houseofdouglas/halloween/stl/eye_back.stl

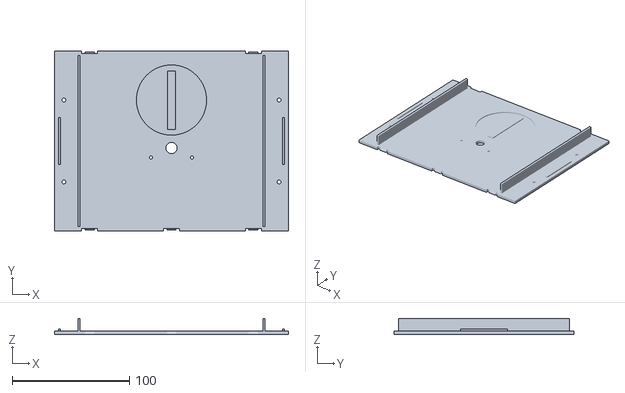
[picture p3: CAD file, 2026-10-10]
stl/eye_back.stl
200.0 x 154.0 x 13.7
