houseofdouglas/halloween/stl/eye_front.stl

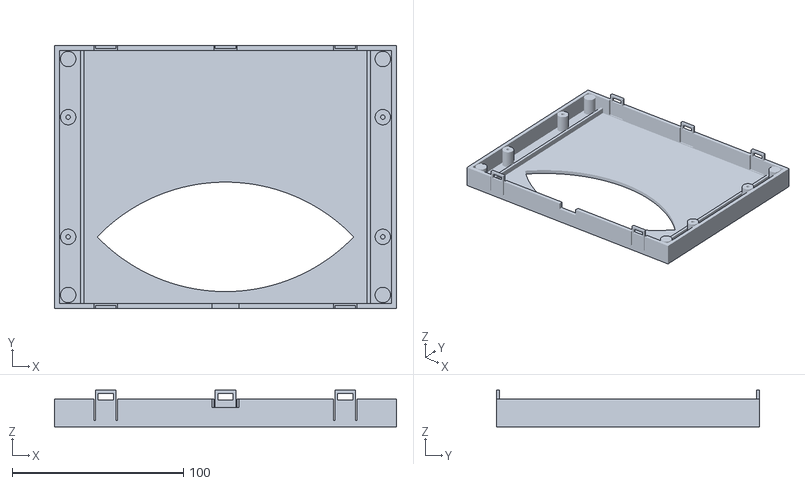
[picture p4: CAD file, 2026-10-10]
stl/eye_front.stl
200.0 x 154.0 x 21.4
