houseofdouglas/halloween/stl/snap_test.stl

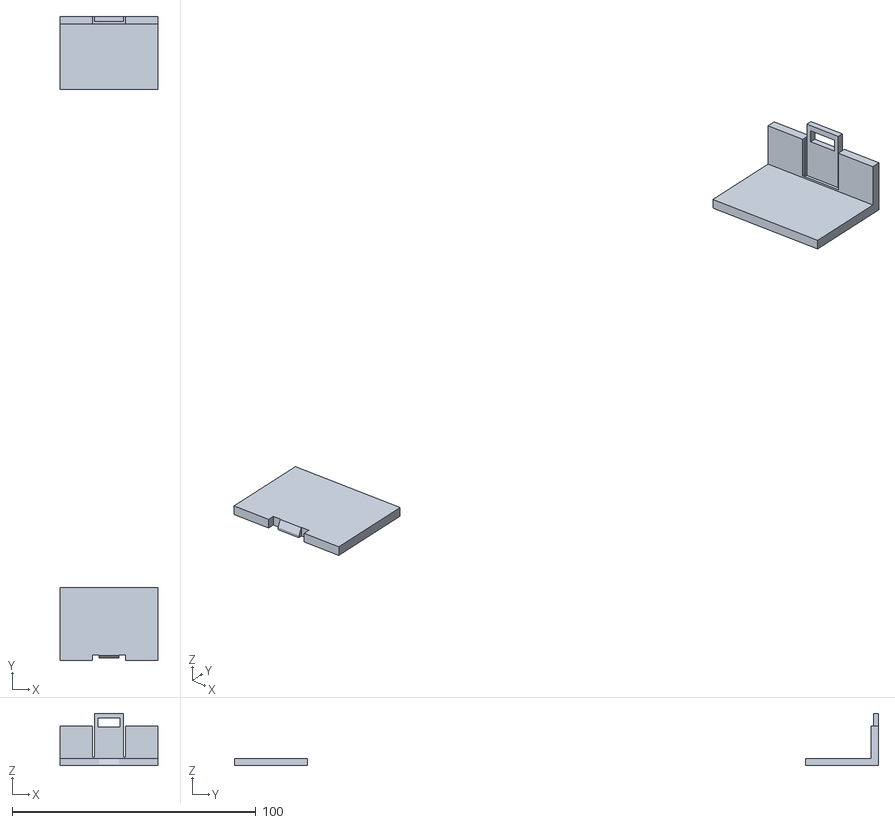
[picture p5: CAD file, 2026-10-10]
stl/snap_test.stl
40.0 x 264.0 x 21.4
