houseofdouglas/halloween/stl/eye_lid.stl

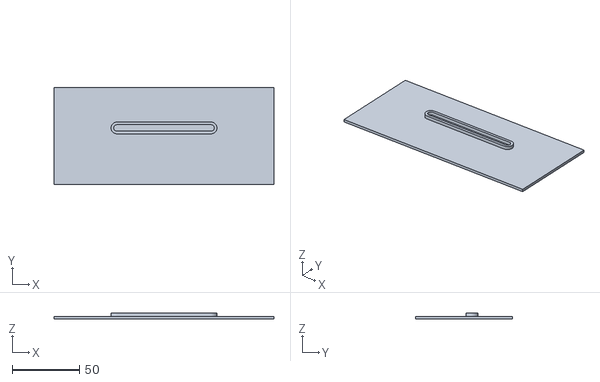
[picture p6: CAD file, 2026-10-10]
stl/eye_lid.stl
164.0 x 72.0 x 4.50
