houseofdouglas/halloween/stl/splice.stl

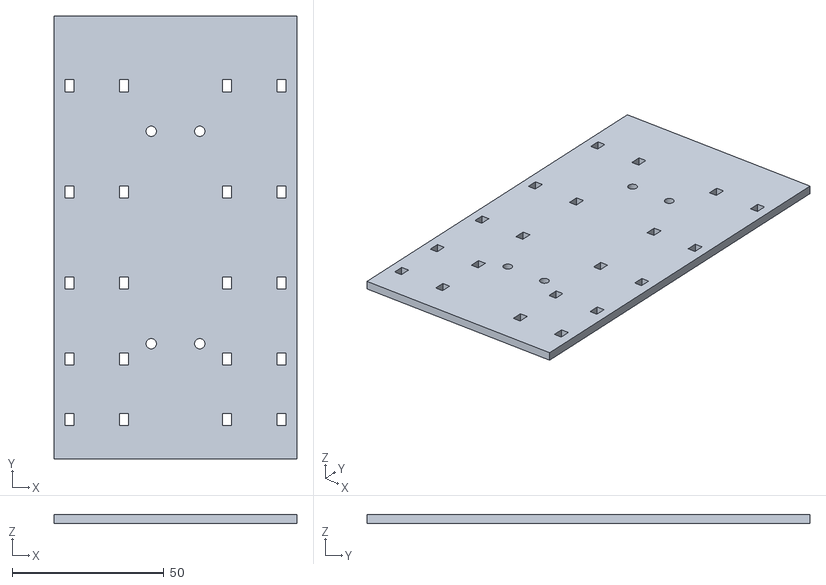
[picture p7: CAD file, 2026-10-10]
stl/splice.stl
80.0 x 146.0 x 3.00
