houseofdouglas/halloween/stl/eye_crank.stl

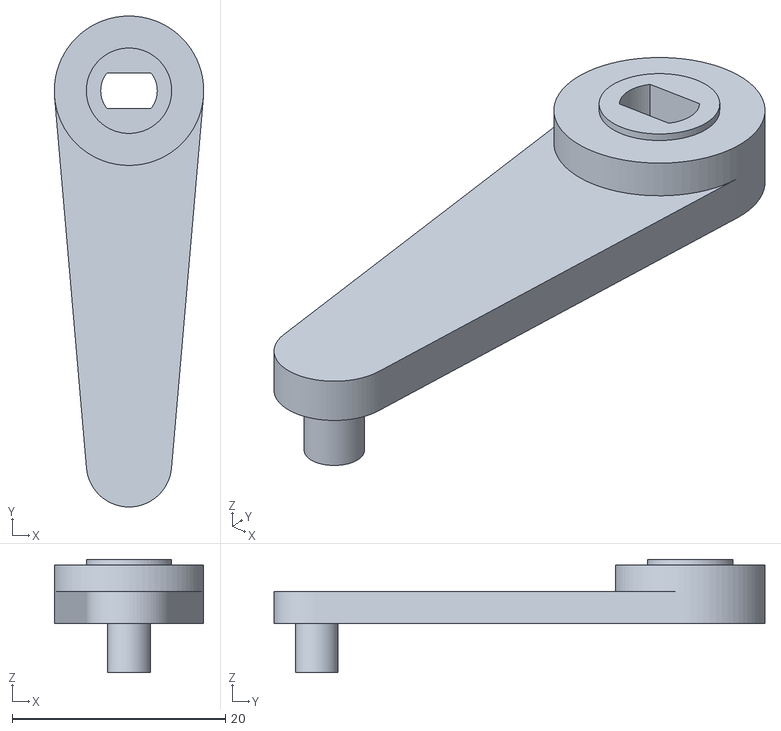
[picture p8: CAD file, 2026-10-10]
stl/eye_crank.stl
14.0 x 46.0 x 10.6
