houseofdouglas/halloween/stl/motor_fit_test.stl

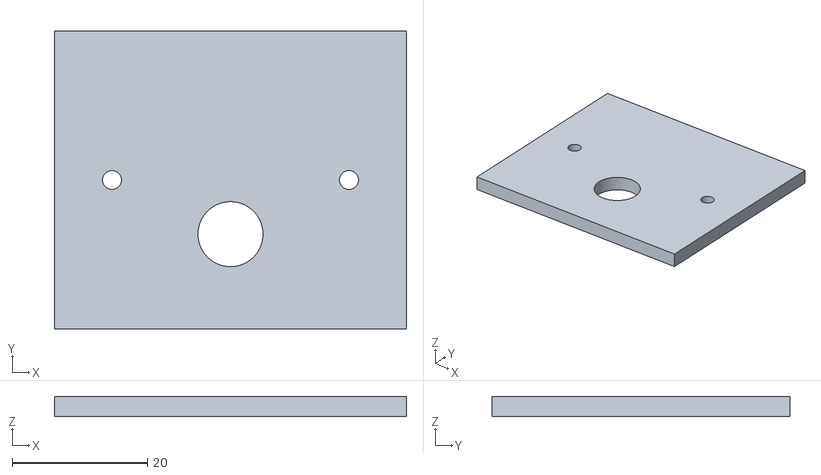
[picture p9: CAD file, 2026-10-10]
stl/motor_fit_test.stl
52.0 x 44.0 x 3.00
